bentyeh/bioe123_BAMFermenter/python_plots/plot_eeprom.png

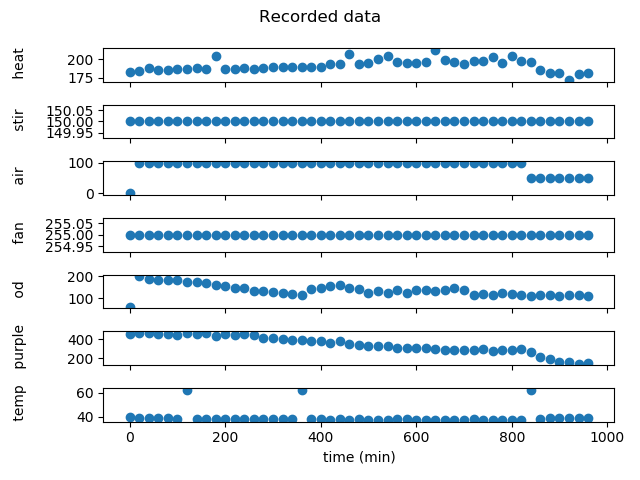
python_plots/plot_eeprom.png
