bentyeh/bioe123_BAMFermenter/Module4_FullFunctionality/plotter.py

"""
Display analog data from Arduino using Python (matplotlib)

Code edited by J. Sganga for Bioe123
Date: 2/20/2017

Original:
Author: Mahesh Venkitachalam
Website: electronut.in
git: https://gist.github.com/electronut/d5e5f68c610821e311b0
"""

import sys, serial
import numpy as np
from collections import deque
import matplotlib.pyplot as plt 
import matplotlib.animation as animation

    
# plot class
class AnalogPlot(object):
  # constr
    def __init__(self, strPort, maxLen, baud_rate):
      # open serial port
      self.arduino = serial.Serial(strPort, baud_rate)
      self.maxLen  = maxLen
      # grab a printed line to check length
      stream = self.arduino.readline()
      stream_values = [float(val) for val in stream.split()]
      # plot nothing, but want handle to line object
      self.n_lines = len(stream_values)
      self.lines = []
      for i in range(self.n_lines):
        line, = plt.plot([], [])
        self.lines.append(line)
      self.data    = []
      for i in range(self.n_lines):
        self.data.append(deque([0.0]*maxLen))

    # add data
    def add_to_plot(self, stream_values):
        for i in range(self.n_lines):
            val    = stream_values[i]
            line   = self.lines[i]
            data_q = self.data[i]
            data_q.popleft()
            data_q.append(val)
            line.set_data(np.linspace(-self.maxLen,0,self.maxLen), data_q)

    # update plot
    def update(self, frameNum):
      try:
          stream = self.arduino.readline()
          ### if you want to plot in real-time (no buffer), uncomment next two lines
          # while self.arduino.inWaiting() > 0: # clears buffer
          #     stream = self.arduino.readline()
          stream_values = [float(val) for val in stream.split()]
          self.add_to_plot(stream_values)
      except KeyboardInterrupt:
          print('exiting')
      
    # clean up
    def close(self):
      # close serial
      self.arduino.flush()
      self.arduino.close()    

# main() function
def main(port, baud_rate):

    print('reading from serial port ' + port + '...')

    # plot parameters
    data_length = 100 # number of points shown in window
    
    # set up figure
    fig = plt.figure()
    plt.xlabel('Time History')
    plt.ylabel('Value')
    plt.title('Real Time Plot for Port ' + port)
    x_min, x_max = -data_length, 5
    plt.xlim([x_min, x_max])
    y_min, y_max = 0, 1023
    plt.ylim([y_min, y_max])

    

    analogPlot = AnalogPlot(port, data_length, baud_rate)
    print('plotting data...')

    anim = animation.FuncAnimation(fig, analogPlot.update, 
                                 interval=50)

    # show plot
    plt.show()

    # clean up
    analogPlot.close()

    print('exiting.')
  
"""
call main, CHANGE THESE VALUES!!!
replace 'COM6' with whatever the tools pulldown bar shows you're connected to
for mac, it looks like '/dev/cu.usbmodem....' (without the (Arduino/Genuino Micro))
Also, note the arduino puts out data faster than we can plot in real time, so there's 
a delay between the plotted value and the actual value (~1-2 min)

Format for data in Arduino Serial print, data values separated by space, new line for each time point:
Serial.print(data_value_1);
Serial.print(' ');
...
Serial.println(data_value_n);
"""
if __name__ == '__main__':
    main('COM6', 9600)
