bentyeh/bioe123_BAMFermenter/(commit log)

2018-03-06 Fix minor bugs (long int, missing semicolons, etc.). Peltier set point now set to 100 out of 255 (rather than 60)
    [fermenter.ino]
2018-03-06 Fixed some bugs. Known issues: pausing doesn't turn off fan
    [fermenter.ino]
2018-03-08 Updated eeprom.ino to decode temperature, od, and purpleness values. Updated eeprom.py to be able to write eeprom data to text file and display better formatted plots.
2018-03-13 Wifi Control of On-board LED with precursor SPI code
2018-03-14 Updated fermernter Arduino code to output data to software serial
2018-03-14 basic code to run on esp8266 wifi chip to communicate with arduino over SoftwareSerial
2018-03-15 new bug free code
    [wifi_sockets.ino]
2018-03-15 Remove unnecessary print statements from fermenter.ino
2018-03-17 Completely working Module 5: bidirectional control and display of data - Streamlined fermenter.ino code - Pause button tested to work - Plotting done with D3.js - Updated comments
2018-03-17 minor change to Readme to include link to draw.io published diagram for circuit schematic
